adafruit/Adafruit-TPS65131-Split-Power-Supply-PCB/README.md

## Adafruit TPS65131 Split Power Supply Boost Converter - +6 ~ 15 / -6V ~ -15V PCB

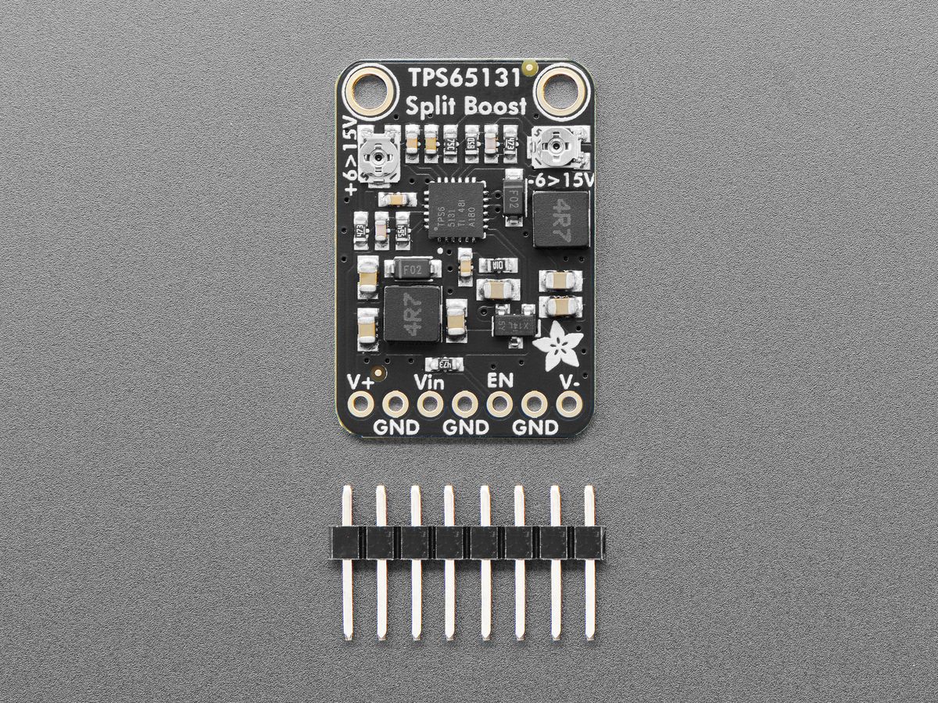
[picture p1: assets/6280.jpg]
<a href="http://www.adafruit.com/products/6280"><br/>
Click here to purchase one from the Adafruit shop</a>

PCB files for the Adafruit TPS65131 Split Power Supply Boost Converter - +6~15 / -6V~-15V. 

Format is EagleCAD schematic and board layout
* https://www.adafruit.com/product/6280

### Description

Need those tricky split-rail voltages for your vintage electronics? The Adafruit TPS65131 Split Rail Boost Converter generates both positive and negative voltage rails from a single 3-5V input. This makes it great for mimicking or replacing a transformer-based power supply or something that needs negative bias. We kept the design compact, and it even has adjustable output pots, so you can tune the voltages from about +6~+15VDC and -6~15VDC. Perfect for use with audio or retro projects now that transformer supplies are hard to get, or if you want to have something that could run on battery or USB.

Features:

* The TPS65131 can generate positive and negative voltages simultaneously
* Adjustable voltage ranges: +6V to +15V and -6V to -15V, these are somewhat approximate because the trimmer pot can vary, you may find +/-0.5V variance on the bookend values
* Input voltage: 3 to 5.5V
* Output current: 150mA from each rail (assuming +12/-12V from 4.5V input). So not good for a motor, best for biasing or powering analog/digital electronics
* Compact breadboard-friendly design with mounting holes and two trimmer pots

We initially designed this to generate a -12V bias voltage on an Apple ][ disk drive, but you could definitely use it for synthesizers/modulars, TTL logic or op-amps that want a wide power supply, biasing LCDs or OLEDs, as well as other uncommon voltages. The trimmers let you tweak the outputs so you could get +6V and -12V or +12 and -8V. 

### License

Adafruit invests time and resources providing this open source design, please support Adafruit and open-source hardware by purchasing products from [Adafruit](https://www.adafruit.com)!

Designed by Limor Fried/Ladyada for Adafruit Industries.

Creative Commons Attribution/Share-Alike, all text above must be included in any redistribution. 
See license.txt for additional details.
