adafruit/Adafruit-TPS65131-Split-Power-Supply-PCB/Adafruit TPS65131 Split Power Supply.brd

## EAGLE design Adafruit TPS65131 Split Power Supply.brd (2025-03-13)

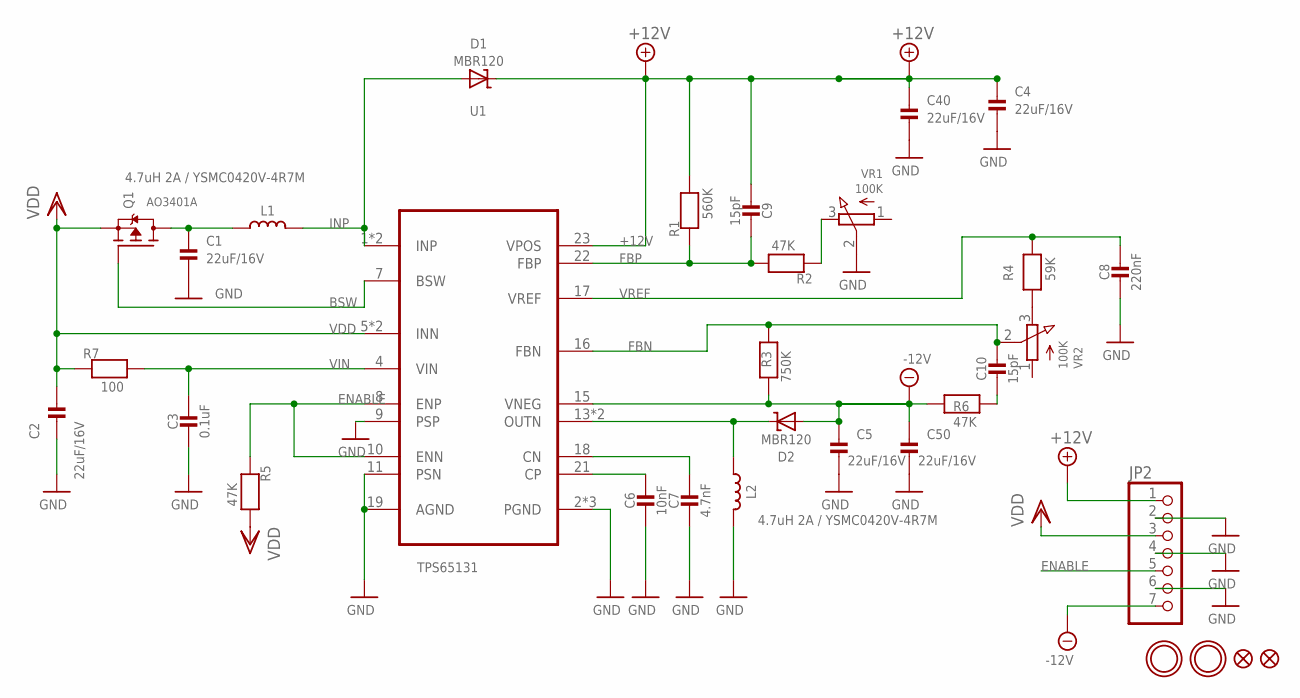
[picture p2: schematic Adafruit TPS65131 Split Power Supply.sch]

Parts:
C1, C2, C4, C5, C40, C50: 22uF/16V; 0805-NO
C3: 0.1uF; 0603-NO
C6: 10nF; 0603-NO
C7: 4.7nF; 0603-NO
C8: 220nF; 0603-NO
C9, C10: 15pF; 0603-NO
D1, D2: MBR120; SOD-123FL
FID1, FID2: FIDUCIAL_0.5MM
JP2: HEADER-1X7THICKER; 1X07_ROUND_76
L1, L2: 4.7uH 2A / YSMC0420V-4R7M; INDUCTOR_4X4MM_NR401
Q1: AO3401A; SOT23-WIDE
R1: 560K; 0603-NO
R2, R5, R6: 47K; 0603-NO
R3: 750K; 0603-NO
R4: 59K; 0603-NO
R7: 100; 0603-NO
U1: TPS65131; QFN24_4MM
U$1, U$2: MOUNTINGHOLE2.5; MOUNTINGHOLE_2.5_PLATED
VR1, VR2: 100K; TRIMPOT_BOURNS_TC33X-2

Connections:
+12V: C4.2, C9.1, C40.2, D1.C, JP2.1, R1.2, U1.23 (VPOS)
-12V: C5.2, C50.2, D2.A, JP2.7, R3.1, R6.1, U1.15 (VNEG)
BSW: Q1.1 (G), U1.7 (BSW)
ENABLE: JP2.5, R5.1, U1.8 (ENP), U1.10 (ENN)
FBN: C10.2, R3.2, U1.16 (FBN), VR2.2 (S)
FBP: C9.2, R1.1, R2.2, U1.22 (FBP)
GND: C1.1, C2.1, C3.1, C4.1, C5.1, C6.1, C7.1, C8.1, C40.1, C50.1, JP2.2, JP2.4, JP2.6, L2.P$2 (2), U1.2 (PGND), U1.3 (PGND), U1.9 (PSP), U1.11 (PSN), U1.19 (AGND), U1.25 (PGND), VR1.2 (S)
INP: D1.A, L1.P$2 (2), U1.1 (INP), U1.24 (INP)
unnamed: C6.2, U1.21 (CP)
unnamed: C1.2, L1.P$1 (1), Q1.3 (D)
unnamed: R2.1, VR1.3 (E)
unnamed: R4.1, VR2.3 (E)
unnamed: C10.1, R6.2
unnamed: C7.2, U1.18 (CN)
OUTN: D2.C, L2.P$1 (1), U1.13 (OUTN), U1.14 (OUTN)
VDD: C2.2, JP2.3, Q1.2 (S), R5.2, R7.1, U1.5 (INN), U1.6 (INN)
VIN: C3.2, R7.2, U1.4 (VIN)
VREF: C8.2, R4.2, U1.17 (VREF)

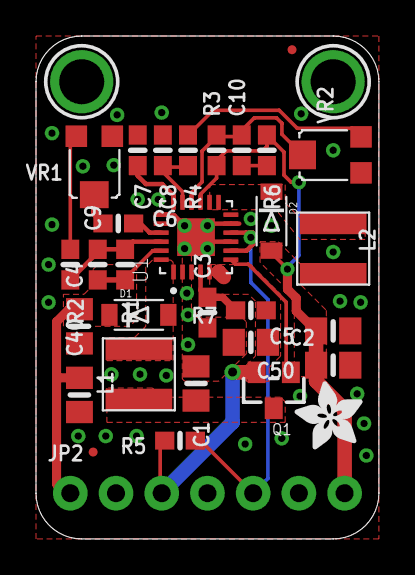
[picture p3: board Adafruit TPS65131 Split Power Supply.brd from above]

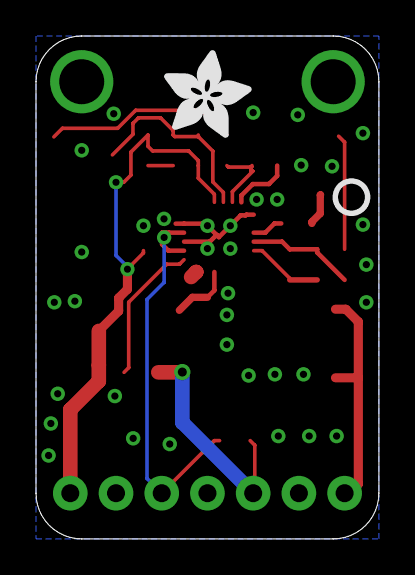
[picture p4: board Adafruit TPS65131 Split Power Supply.brd from below]

Board: 2 copper layers, 19.1 x 27.9 mm, 47 parts (4 on the bottom side), 18 nets.

Other parts of the board:
PLABEL0: PLABEL0
PLABEL1: PLABEL1
PLABEL2: PLABEL2
PLABEL3: PLABEL3
PLABEL4: PLABEL4
PLABEL5: PLABEL5
PLABEL6: PLABEL6
PLABEL7: PLABEL7
PLABEL8: PLABEL8
PLABEL9: PLABEL9
PLABEL10: PLABEL10
PLABEL11: PLABEL11
U$3: ADAFRUIT_3.5MM
U$4: ADAFRUIT_5MM
U$5: PCBFEAT-REV-040
